ryood/GateEX/IMG_20210524_070436.jpg

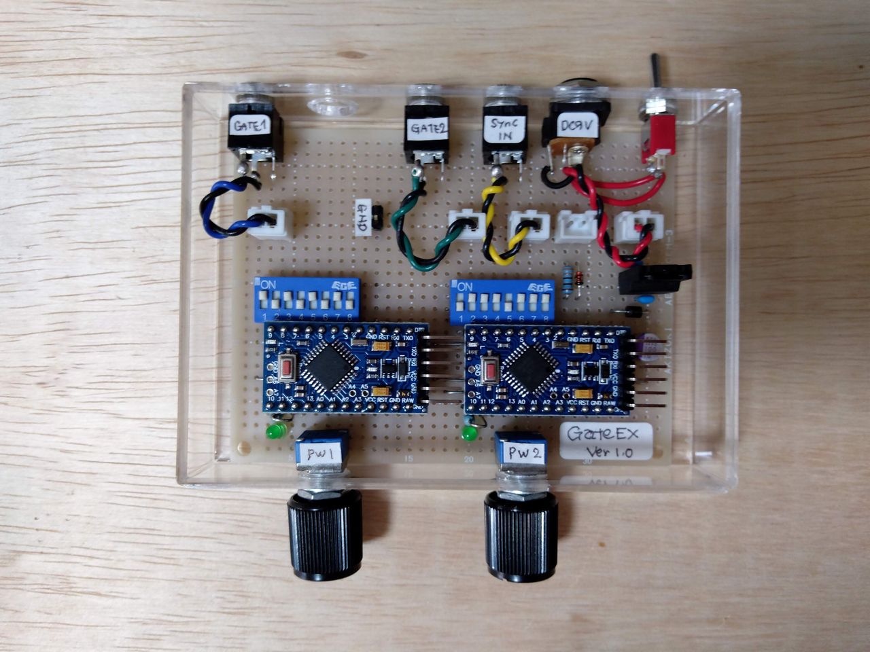
IMG_20210524_070436.jpg
