ryood/GateEX/20210410_233717.png

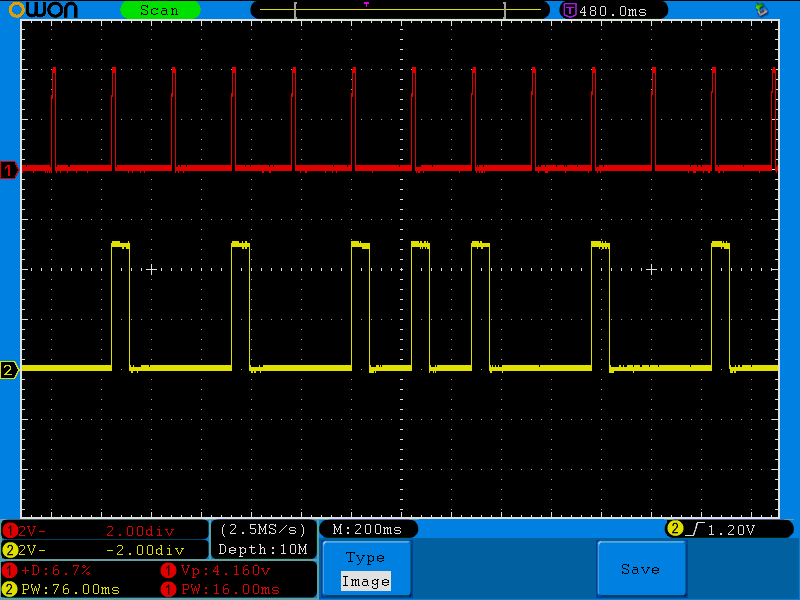
20210410_233717.png
