ryood/GateEX/fritzing/Arduino_DIP_SW_ブレッドボードr.png

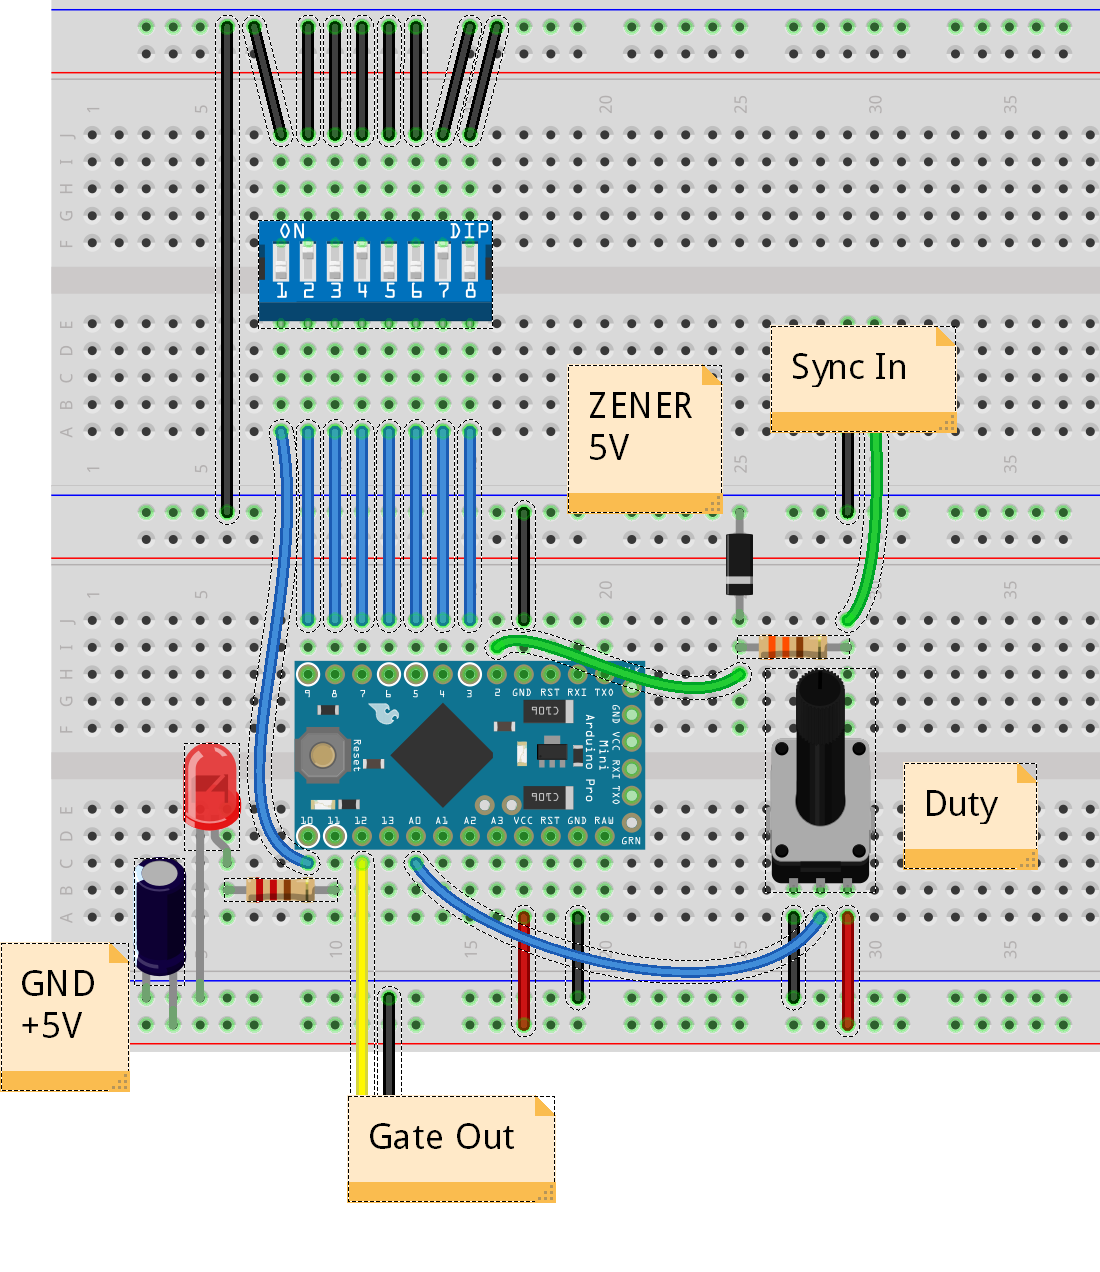
fritzing/Arduino_DIP_SW_ブレッドボードr.png
