ryood/GateEX/Gate EX ブロック図.png

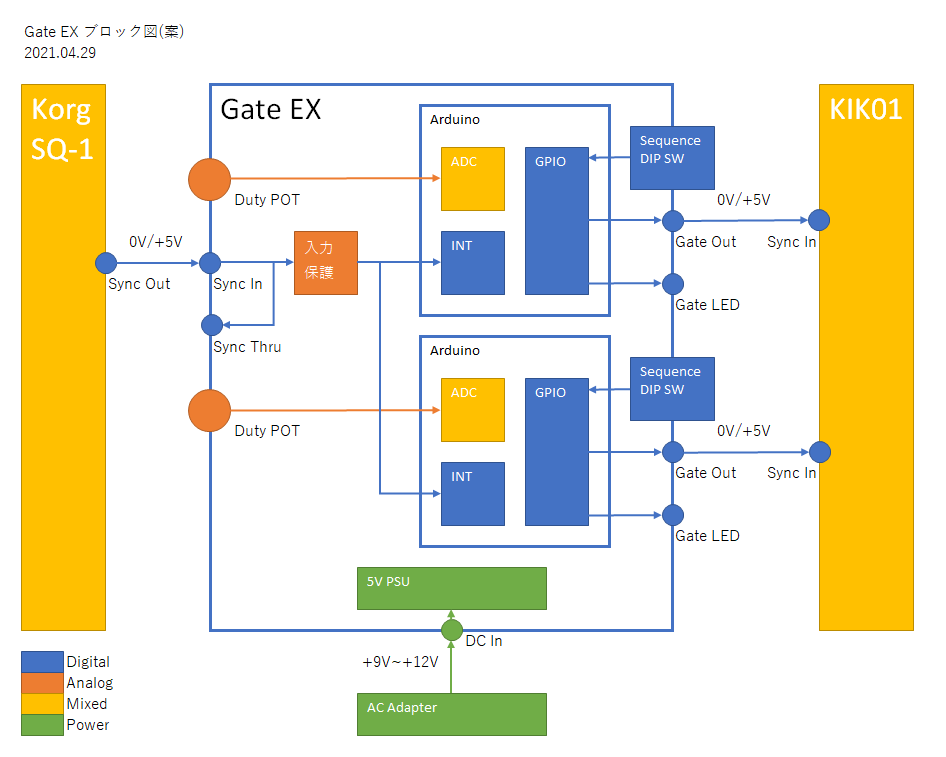
Gate EX ブロック図.png
