ryood/GateEX/GateEX Sync Division.png

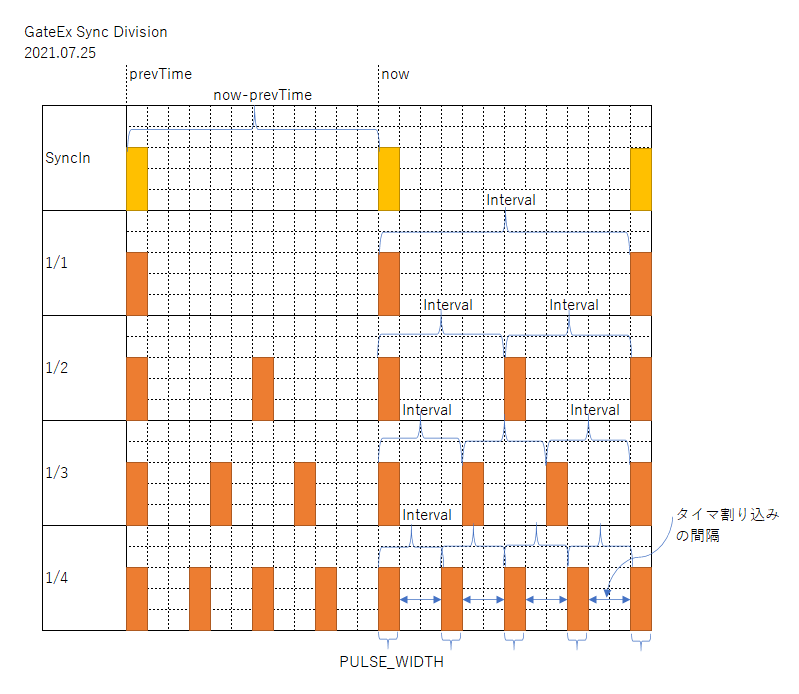
GateEX Sync Division.png
