ryood/GateEX/GateEX_Out.png

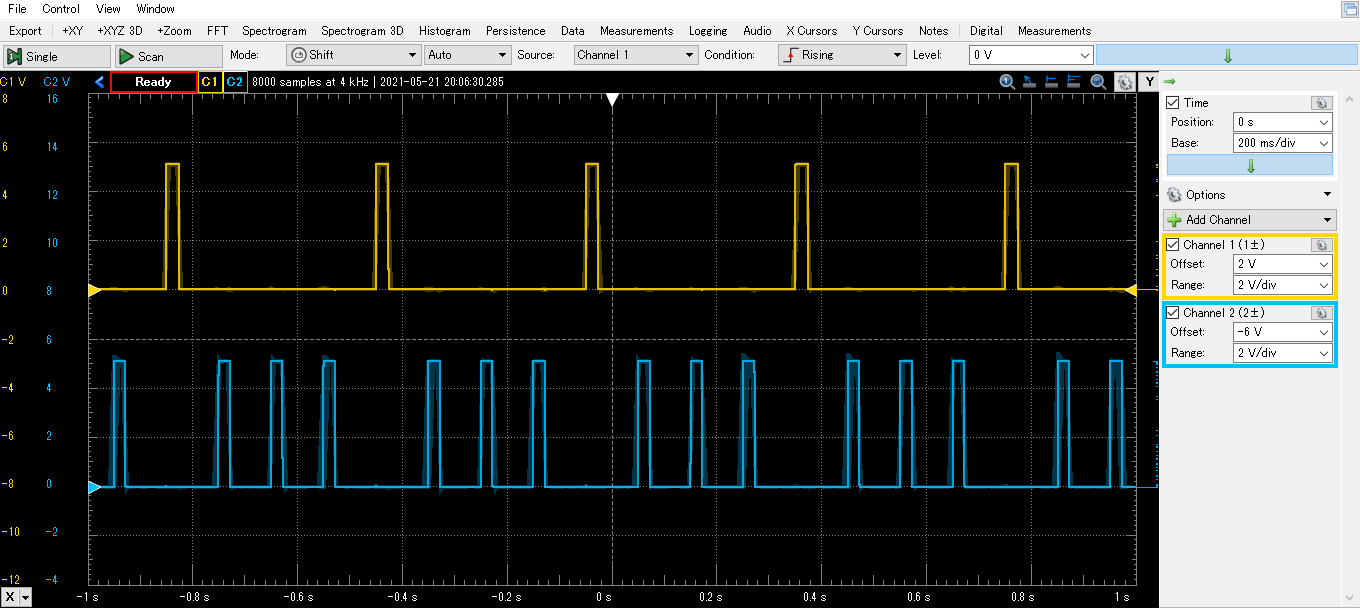
GateEX_Out.png
