ryood/GateEX/KiCAD/GateEX_brd.PNG

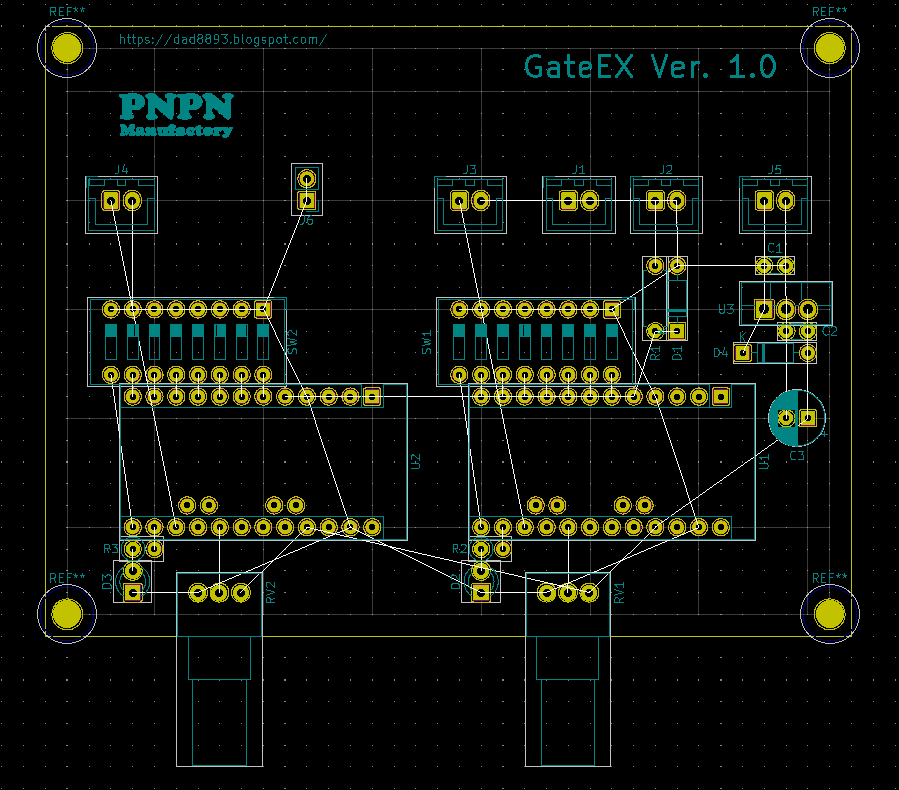
KiCAD/GateEX_brd.PNG
