ryood/GateEX/KiCAD/GateEX_sch.png

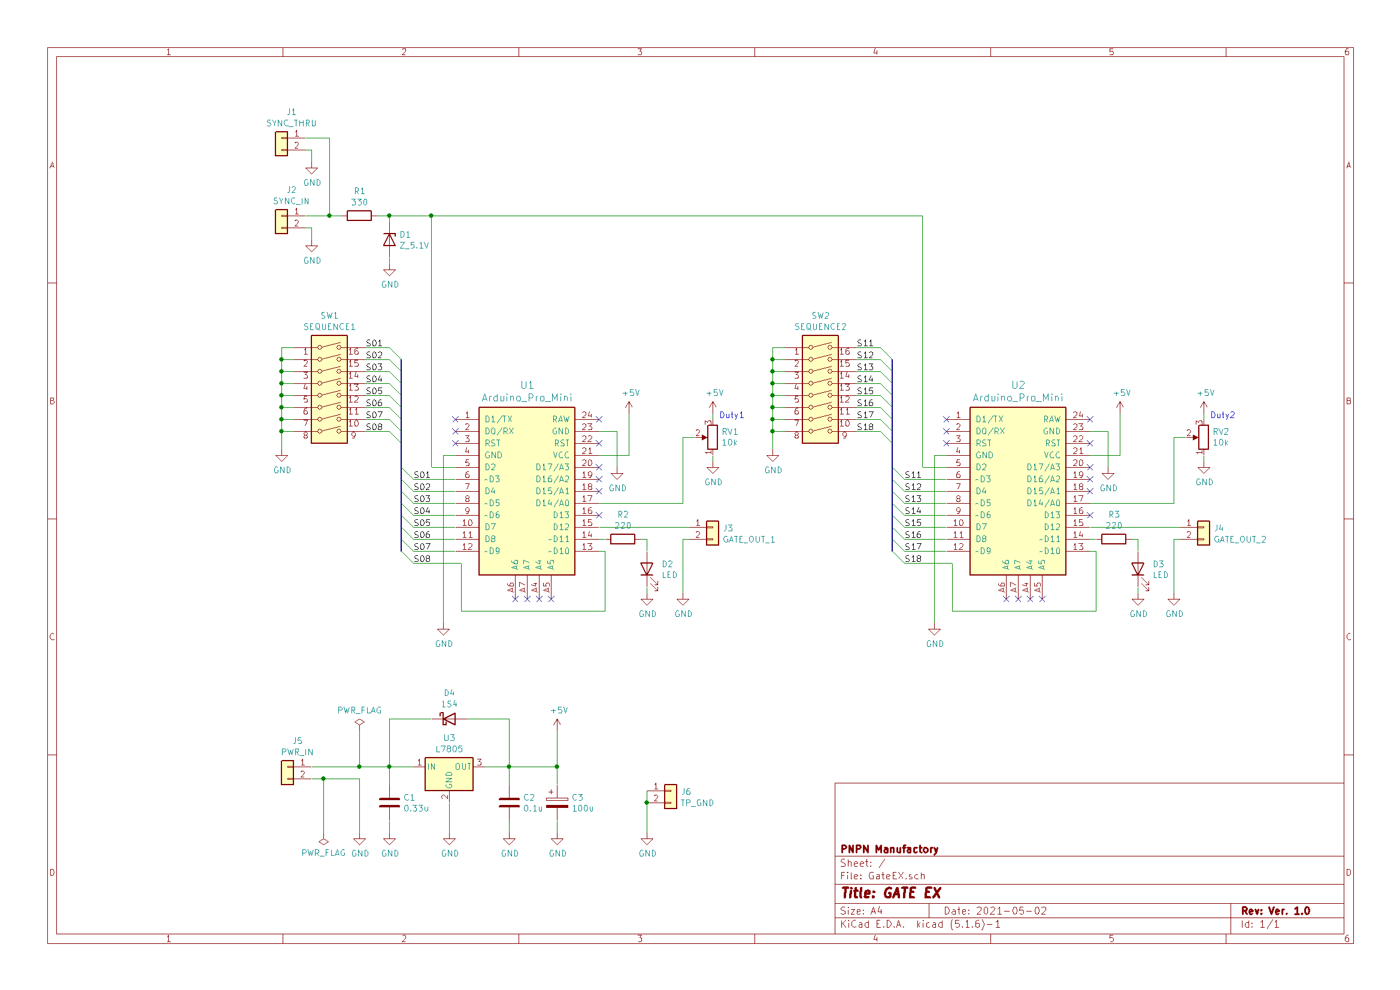
KiCAD/GateEX_sch.png
