ryood/GateEX/(list of files, cad)

Other CAD files:
Case/GateEx_Case.dwg
