ryood/GateEX/(list of files, drawings)

Other design files:
fritzing/Arduino_DIP_SW.fzz
fritzing/MCP23S17_DIP_SW.fzz
