ryood/GateEX/KiCAD/GateEX/GateEX.kicad_pcb

## KiCad design KiCAD/GateEX/GateEX.kicad_pcb (2021-05-24)

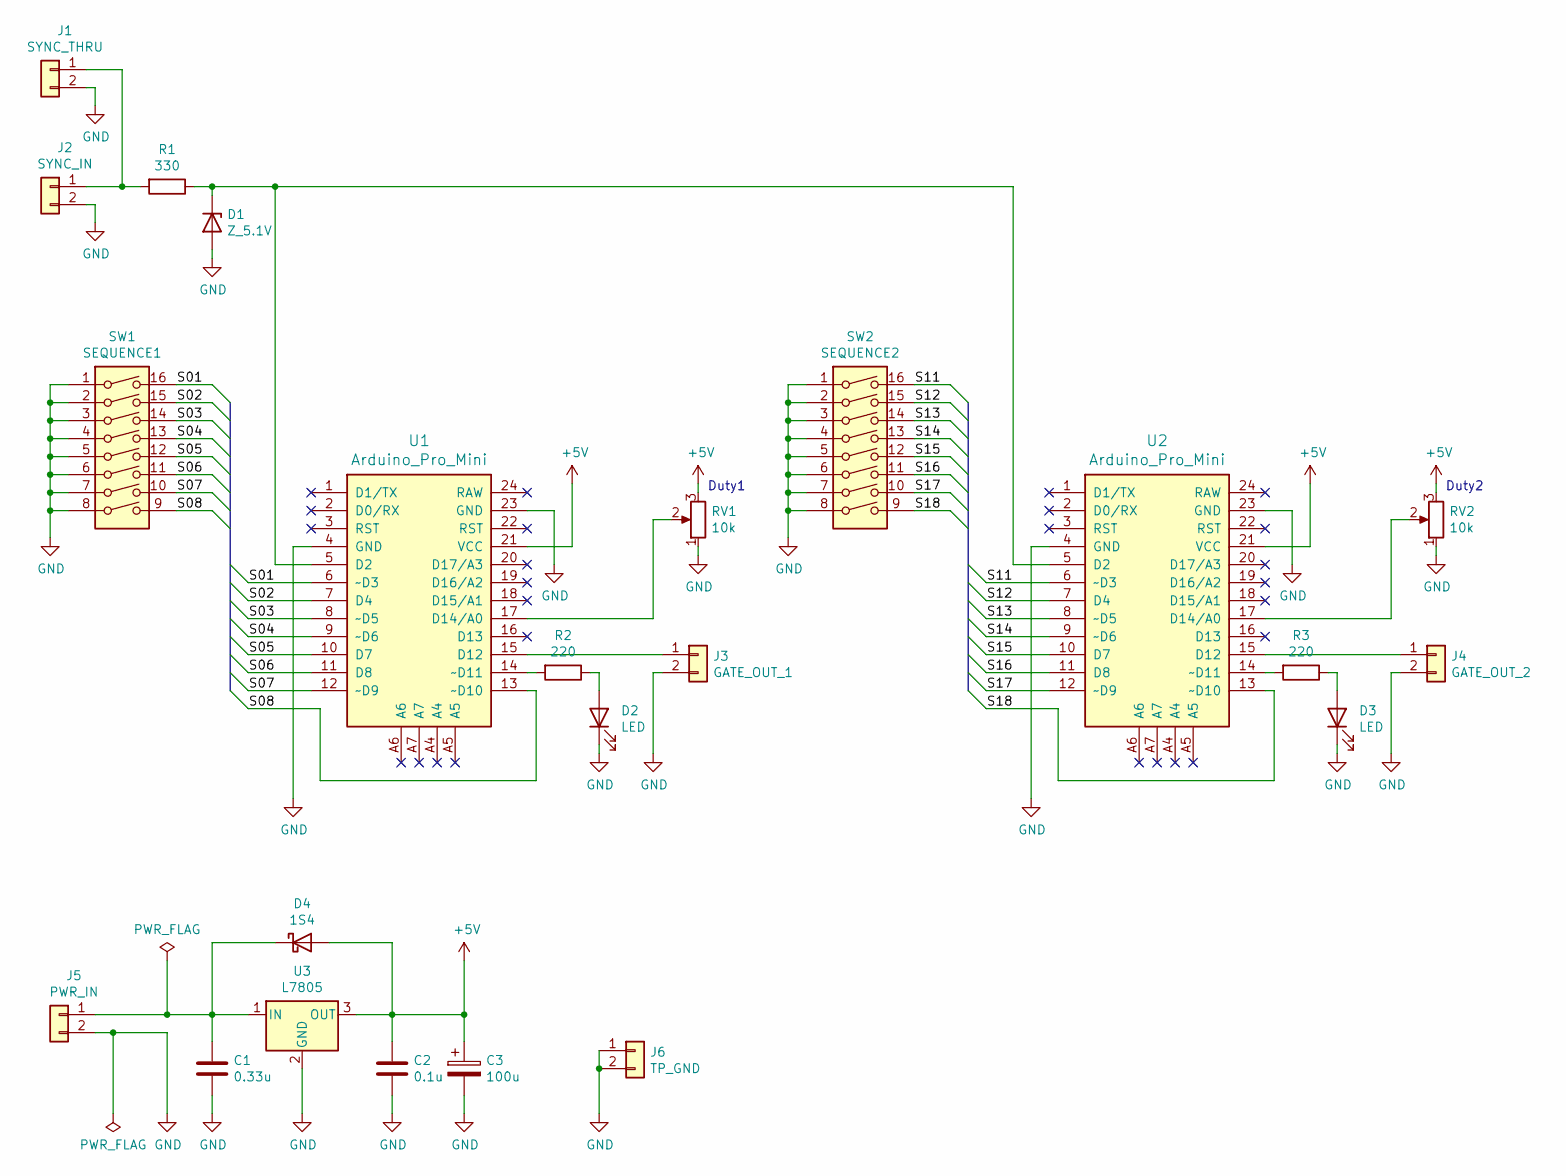
[picture p9: schematic GateEX.sch, GATE EX]

Parts:
C1: 0.33u; C_Disc_D3.0mm_W1.6mm_P2.50mm
C2: 0.1u; C_Disc_D3.0mm_W1.6mm_P2.50mm
C3: 100u; CP_Radial_D6.3mm_P2.50mm
D1: Z_5.1V; D_DO-35_SOD27_P7.62mm_Horizontal
D2, D3: LED; LED_D3.0mm
D4: 1S4; D_DO-35_SOD27_P7.62mm_Horizontal
J1: SYNC_THRU; JST_XH_B2B-XH-A_1x02_P2.50mm_Vertical
J2: SYNC_IN; JST_XH_B2B-XH-A_1x02_P2.50mm_Vertical
J3: GATE_OUT_1; JST_XH_B2B-XH-A_1x02_P2.50mm_Vertical
J4: GATE_OUT_2; JST_XH_B2B-XH-A_1x02_P2.50mm_Vertical
J5: PWR_IN; JST_XH_B2B-XH-A_1x02_P2.50mm_Vertical
J6: TP_GND; PinHeader_1x02_P2.54mm_Vertical
R1: 330; R_Axial_DIN0207_L6.3mm_D2.5mm_P7.62mm_Horizontal
R2, R3: 220; R_Axial_DIN0207_L6.3mm_D2.5mm_P2.54mm_Vertical
RV1, RV2: 10k; Potentiometer_Alps_RK097_Single_Horizontal
SW1: SEQUENCE1; SW_DIP_SPSTx08_Slide_9.78x22.5mm_W7.62mm_P2.54mm
SW2: SEQUENCE2; SW_DIP_SPSTx08_Slide_9.78x22.5mm_W7.62mm_P2.54mm
U1, U2: Arduino_Pro_Mini
U3: L7805; TO-220F-3_Vertical

Connections:
+5V: C2.1, C3.1, D4.2 (A), RV1.3, RV2.3, U1.21 (VCC), U2.21 (VCC), U3.3 (OUT)
/S01: SW1.16, U1.6 (~~D3)
/S02: SW1.15, U1.7 (D4)
/S03: SW1.14, U1.8 (~~D5)
/S04: SW1.13, U1.9 (~~D6)
/S05: SW1.12, U1.10 (D7)
/S06: SW1.11, U1.11 (D8)
/S07: SW1.10, U1.12 (~~D9)
/S08: SW1.9, U1.13 (~~D10)
/S11: SW2.16, U2.6 (~~D3)
/S12: SW2.15, U2.7 (D4)
/S13: SW2.14, U2.8 (~~D5)
/S14: SW2.13, U2.9 (~~D6)
/S15: SW2.12, U2.10 (D7)
/S16: SW2.11, U2.11 (D8)
/S17: SW2.10, U2.12 (~~D9)
/S18: SW2.9, U2.13 (~~D10)
GND: C1.2, C2.2, C3.2, D1.2 (A), D2.1 (K), D3.1 (K), J1.2, J2.2, J3.2, J4.2, J5.2, J6.1, J6.2, RV1.1, RV2.1, SW1.1, SW1.2, SW1.3, SW1.4, SW1.5, SW1.6, SW1.7, SW1.8, SW2.1, SW2.2, SW2.3, SW2.4, SW2.5, SW2.6, SW2.7, SW2.8, U1.4 (GND), U1.23 (GND), U2.4 (GND), U2.23 (GND), U3.2 (GND)
unnamed: C1.1, D4.1 (K), J5.1, U3.1 (IN)
unnamed: D1.1 (K), R1.1, U1.5 (D2), U2.5 (D2)
unnamed: D2.2 (A), R2.1
unnamed: D3.2 (A), R3.1
unnamed: J1.1, J2.1, R1.2
unnamed: J3.1, U1.15 (D12)
unnamed: J4.1, U2.15 (D12)
unnamed: R2.2, U1.14 (~~D11)
unnamed: R3.2, U2.14 (~~D11)
unnamed: RV1.2, U1.17 (D14/A0)
unnamed: RV2.2, U2.17 (D14/A0)

Notes on the sheet:
Duty2
Duty1

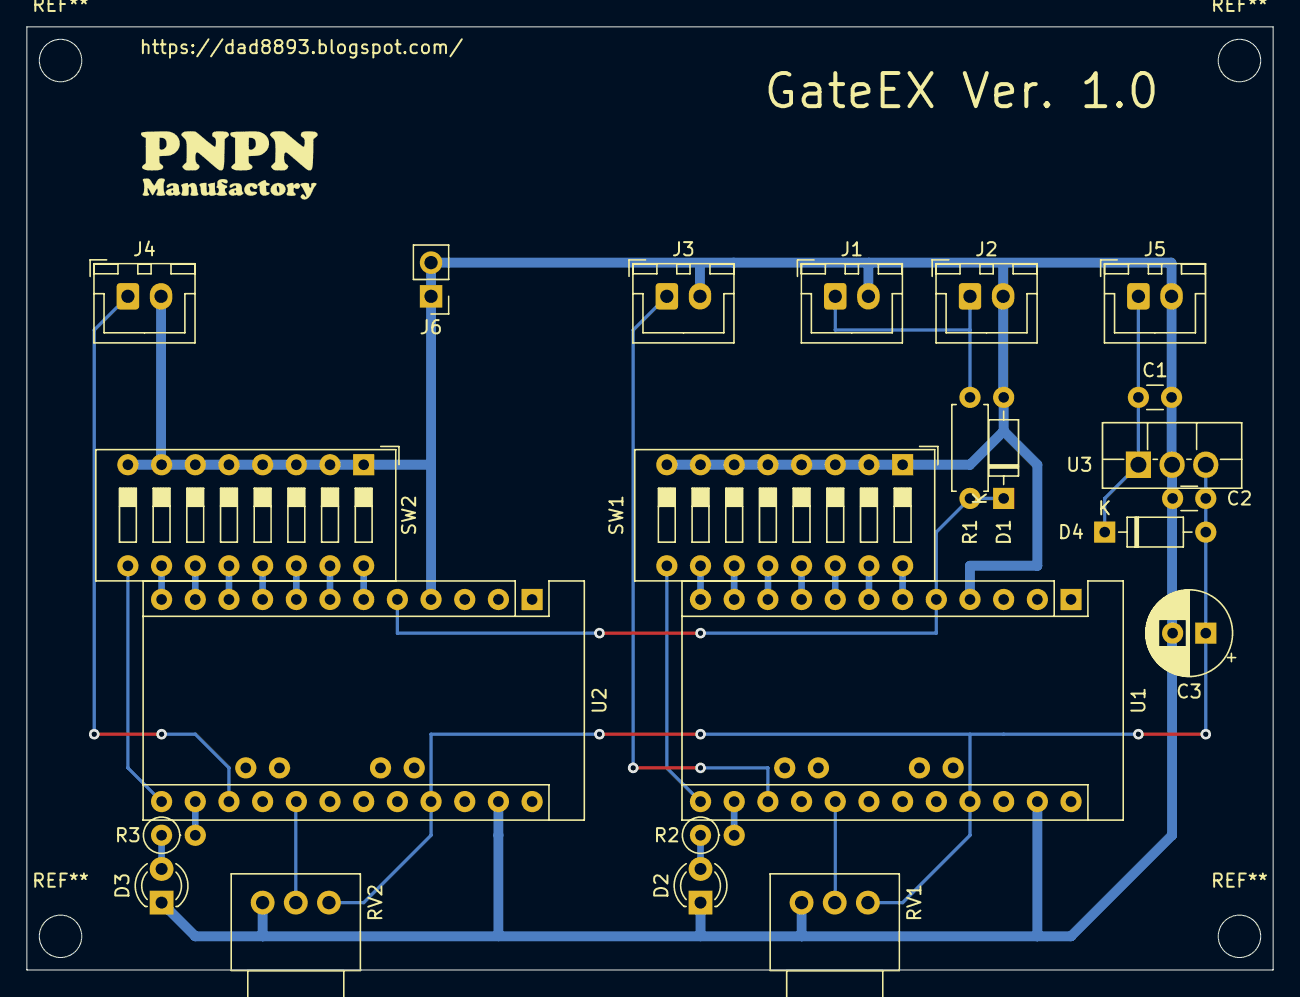
[picture p10: board GateEX.kicad_pcb from above]

Board: 2 copper layers, 94.0 x 71.1 mm, 23 parts (0 on the bottom side), 29 nets.
